rodrigo-olaya/esp32-home-automation/(threads)

Thread 5 (2025-08-29):

Test thermistor connection

rodrigo-olaya, 2025-08-29:
## Description

Need to ensure hardware connections are correct. To do this, need to research what the appropriate function calls are for the GPIOs, specifically the D13 pin. The thermistor being used is DS18B20.

## Potential next steps

- [ ] Research Espressif documentation to find appropriate calls for GPIO pins
- [ ] Write temporary code to ensure data retrieval
- [ ] Log temp and data

## Useful Information

Link to ESP-IDF API Documentation: https://docs.espressif.com/projects/esp-idf/en/stable/esp32/api-reference/index.html
OneWire: https://components.espressif.com/components/esp-idf-lib/onewire/versions/1.0.7/readme
DS18X20: https://components.espressif.com/components/esp-idf-lib/ds18x20/versions/1.2.8/readme

Closed 2025-09-01.

Thread 6 (2025-08-30):

Fix incorrect thermistor readings

rodrigo-olaya, 2025-08-30:
## Description

Thermistor address is detected and temperatures are received. However, temperature readings are incorrect.

## Potential next steps

- [x] Add a resistor for more accurate readings

rodrigo-olaya, 2025-09-01:
#### Steps taken to fix:

The DS18B20 sensor came with a 47k ohm resistor, and the required component is a 4.7k ohm resistor. Fixed by using a 5.1k ohm resistor, which gave accurate readings. Need to get a 4.7k resistor for even more accurate readings.

Closed 2025-09-01.

Thread 7 (2025-09-01):

Improve hardware connections

rodrigo-olaya, 2025-09-01:
## Description

The DS18B20 sensor wiring is not optimal for breadboard development, since the exposed wires are too thin and short.

## Potential next steps

- [x] Get screw on terminals

rodrigo-olaya, 2025-09-07:
Hardware connection finished. Fixed using Screw-on terminal

Closed 2025-09-07.

Thread 8 (2025-09-01):

Move temporary thermistor logic from main to designated space

rodrigo-olaya, 2025-09-01:
## Description

The main logic for the thermistor is currently in main. Need to move to a multi-threaded design and separate files for each component.

## Potential next steps

- [x] Create a new file designated for the thermistor
- [x] Research FreeRTOS documentation to learn how threads are handled in this RTOS
- [x] Call thermistor logic from main using a thread

Closed 2025-09-26.

Thread 11 (2025-09-07):

Add connections for SHT3X

rodrigo-olaya, 2025-09-07:
## Description
Research and connect humidity sensor SHT3X.

## Potential next steps
- [ ] Research documentation for I2C connections
- [ ] Connect on breadboard

## Useful links
- ESP32 pinout: https://www.espboards.dev/esp32/esp32doit-devkit-v1/

Closed 2025-09-27.

Thread 12 (2025-09-07):

Create a scalable sensor architecture

rodrigo-olaya, 2025-09-07:
## Description
As more sensors/motors are added, a generic function is needed to send data from the sensors to the control logic.

## New File structure

### Sensor reading
- thermistor.c -> read thermistor data
- thermistor.h -> thermistor definitions
- humidity_sensor.c -> read humidity and second temperature
- humidity_sensor.h -> SHT3X definitions

### Sensor Data Transfer
- sensors.c -> reusable logic to send sensor data to control
- sensors.h -> reusable definitions

### Logic
- control.c -> Handle Logic and decision-making
- control.h

### Communication
- queues.c -> Initialize queues
- queues.h -> Define all queues
- gpio_config.c -> Initialize GPIOs
- gpio_config.h -> define GPIOs

Closed 2025-10-03.

Thread 9 (2025-09-07):

Add humidity sensor

rodrigo-olaya, 2025-09-07:
## Description
Need to add SHT humidity sensor. This includes soldering, wire connections, and software logic.

## Potential steps
- [ ] Solder connections
- [ ] Locate I2C pin in ESP-32
- [ ] Read humidity in main()
- [ ] Move logic to designated space (File and thread)

Thread 17 (2025-09-11):

Publish ESP32 sensor data to broker

rodrigo-olaya, 2025-09-11:
## Description
For testing purposes only. Once we have mosquitto set up, test it by using sender/receiver scripts.

Closed 2025-09-13.

Thread 23 (2025-09-19):

Add logic to handle mosquitto errors

rodrigo-olaya, 2025-09-19:
## Description
The main logic for the mosquitto interactions has been developed, but the code does not account for failed connections.

## Potential next steps
- [ ] After each mosquitto/MQTT method call, perform a check and log in case of failure.

rodrigo-olaya, 2025-09-21:
Not longer applicable as per #24

Closed 2025-09-21.

Thread 24 (2025-09-20):

Move from mosquitto to ESP-MQTT

rodrigo-olaya, 2025-09-20:
## Description
While mosquitto is supported as a broker in Raspberry Pi, it cannot be linked to ESP-IDF. There is a need to move towards the native `esp-mqtt`.

Thread 25 (2025-09-21):

MQTT connection is not stable

rodrigo-olaya, 2025-09-21:
## Description
MQTT messages published from ESP32 to Raspberry Pi are reaching successfully, and updates can be seen in Home Assistant. However, there are several errors in the logs that seem to be related to netwrok timing issues.

Thread 29 (2025-09-28):

Add SHT3x to HomeAssistant

rodrigo-olaya, 2025-09-28:
## Description
Currently, the SHT31 sensor is capable of reading and logging temperature and humidity once. The SHT31 methods are being called from `main.c` once. The logic needs to be updated to read and publish data continuously.

Closed 2025-10-03.

Thread 30 (2025-09-28):

MoveSHT3x logic to the scalable thread architecture

rodrigo-olaya, 2025-09-28:
## Description
The thread architecture is currently only handling one DS18B20 device. The logic need to be updated to add the new SHT3x sensor.

## Potential Next Steps
- [ ] Create a structure for the type and address of each device
- [ ] Add readings to the sensor queue, which will also handle publishing

Closed 2025-10-03.

Thread 31 (2025-09-28):

Update the HomeAssistant config to include the SHT3x sensor

rodrigo-olaya, 2025-09-28:
## Description
Currently, HomeAssistant is only showing DS18B20 thermistor readings. The HomeAssistant configuration needs to be updated to include the new SHT31 readings.

## Potential next steps
- [ ] Ensure readings are handled as per #30.
- [ ] Add a new MQTT sensor in HomeAssistant
- [ ] Test using MQTT and mosquitto

Closed 2025-10-03.

Thread 37 (2025-10-04):

Create Repo for CAD designs

rodrigo-olaya, 2025-10-04:
## Description
ESP32 micros need to be protected, especially for the camera outside. Need a new repo to separate code from these larger files.
