rodrigo-olaya/esp32-home-automation/temperature-control/main/drivers/gpio_config.h

#ifndef GPIO_CONFIG_H
#define GPIO_CONFIG_H

#include <stdio.h>
#include <inttypes.h>
#include "sdkconfig.h"
#include "freertos/FreeRTOS.h"
#include "freertos/task.h"

#define FF_THERMISTOR_GPIO GPIO_NUMBER_4
#define I2C_SDA_GPIO GPIO_NUMBER_21
#define I2C_SCL_GPIO GPIO_NUMBER_22

#endif // GPIO_CONFIG_H
