rodrigo-olaya/esp32-home-automation/(commit log)

2025-08-29 Add dependencies for thermistor
2025-08-30 Add temporary logic to verify thermistor readings
2025-09-01 Thermistor connection working, receiving correct temperatures
2025-09-04 Add initial thread logic from FreeRTOS book
2025-09-05 Add initial thread logic, broken
    [thermistor.c, thermistor.h]
2025-09-06 Thread for thermistor working
2025-09-09 Add code that communicates data from thermistors to the control logic
2025-09-09 Add sensor and control logic
2025-09-12 Move and rename thermistor GPIO def
2025-09-21 Add event handler, mqtt publish working, pending restructure and small bug fixes for #24
    [main.c, publisher.c, publisher.h]
2025-09-25 Add temporary fix to wifi connection #25, need to add error handling
    [main.c]
2025-09-25 Complete shift from printf to ESP-IDF logger #26
2025-09-25 Transfer actual thermistor data, not a dummy payload #20
2025-09-26 Fix bug: thermistor only reading on power cycle
    [thermistor.c]
2025-09-27 Initial solution for SHT3x sensor, data reading working #9
2025-09-30 Start adding comments to sensor logic #34
2025-10-01 Start modifying thread logic to include different types of data #30
2025-10-02 Start moving sensor definitions to sensors folder #30
2025-10-02 Keep adapting code to publish data from multiple sensors
2025-10-02 Fix double I2C initialization
    [main.c, publisher.c, publisher.h]
2025-10-03 Temperature and Humidity sensors working concurrently #30
2025-10-03 Remove old sensors file from CMake
2025-10-12 Add initial camera project
2025-10-17 Add ESP32-CAM template from documentation
2025-10-21 ESP32 camera captures correctly
    [camera.c, camera.h]
2025-10-22 Camera connection through MQTT working
2025-10-22 Increase frame rate and frame quality, currently at VGA 10fps #40
2025-11-04 Add initial GPIO driver files
2025-11-04 Add GPIO enums, driver definitions
2025-11-04 implement gpio driver api
2025-11-05 modify typedefs to avoid overlaps with esp drivers
    [gpio_driver.c, gpio_driver.h]
2025-11-05 Testing GPIO driver in main, working
2025-11-05 Fix driver, add temp fix to stabilize gpio init
    [gpio_driver.c, main.c]
2025-11-06 Add GPIO 18, add main logic, motor working
2025-11-06 Add directory for motor
2025-11-07 motor running from its designated space
2025-11-11 Start adding mqtt logic to receive heater on requests
2025-11-11 Move heater event subscription to event handler
2025-11-14 Motor working after request, modify speed after request
2025-11-15 Start adding motor config function
2025-11-16 Fix motor pin direction
    [nema17.c]
2025-11-17 Add logic to handle cool/heat in esp32
2025-11-18 Start using temperature conversion functions
2025-11-20 Add header guards where missing
    [gpio_config.h, nema17.h, publisher.h, thermistor.h]
2025-11-20 Clan up config motor
2025-11-23 Prep GPIO driver for I2C driver
2025-11-23 Start I2C driver development
2025-11-23 functions for I2C start, stop and init
2025-11-24 Add write logic for I2C driver
2025-11-24 Start testing I2C driver, received ACK after sending address
2025-11-25 Implement I2C read
2025-11-25 Add helpers for i2c gpio comms
2025-11-26 Update humidity sensor logic to iterate forever
2025-11-26 Integrate humidity sensor into thread arquitecture
2025-12-04 Add encoder init, received ACK
2025-12-06 Add read angle function for magnetic encoder
2025-12-06 Encoder working, need small hardware adjustments to keep measurements steady
2025-12-10 Add mutex for i2c
2025-12-10 Remove espressif dependant i2c code
2025-12-11 Add encoder positions to requirements
2025-12-11 Update motor logic
2025-12-12 Motor goes around to prepare for next command
2025-12-12 update MQTT payloads, fix i2c concurrency bug
    [nema17.c, nema17.h]
2025-12-13 remane smart-fridge to temperature-control
2025-12-13 Remove unnecessary files, add 1-wire requirements
2025-12-13 Start onewire driver implementation
2025-12-16 Add onewire reset, write bit and read bit functions
    [onewire.c, onewire.h]
2025-12-16 fix read bit onewire
    [onewire.c, onewire.h]
2025-12-17 Start testing onewire driver - working
2025-12-18 Onewire driver working, ds18b20 API working
2026-01-15 implement camera heater, not tested
2026-01-15 add enclosure to switch
2026-01-19 Camera only turns on when commanded to
2026-01-19 cleanup camera
2026-01-28 Send images to raspberry Pi for scanner processing
2026-03-19 Start adding schematics
2026-03-28 update gitignore for schematics, track progress
2026-03-28 create and add esp32
